MinervaBots/Trekking/mechanical/assembly/Renders/TK - 02.PNG

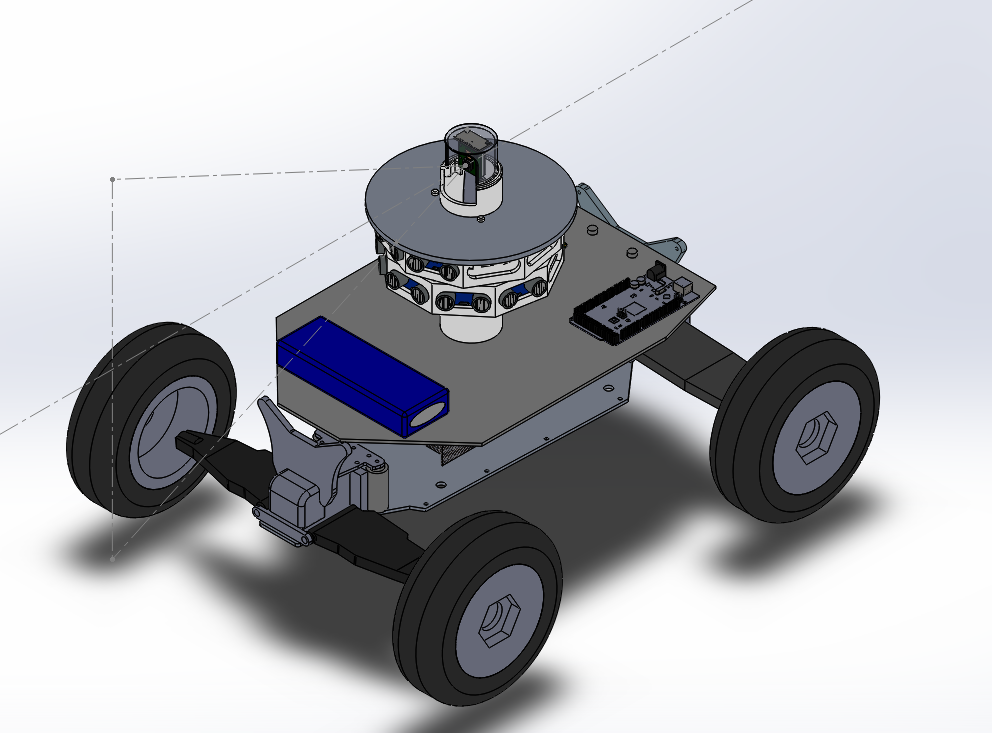
mechanical/assembly/Renders/TK - 02.PNG
