MinervaBots/Trekking/mechanical/assembly/Renders/TK - 03.PNG

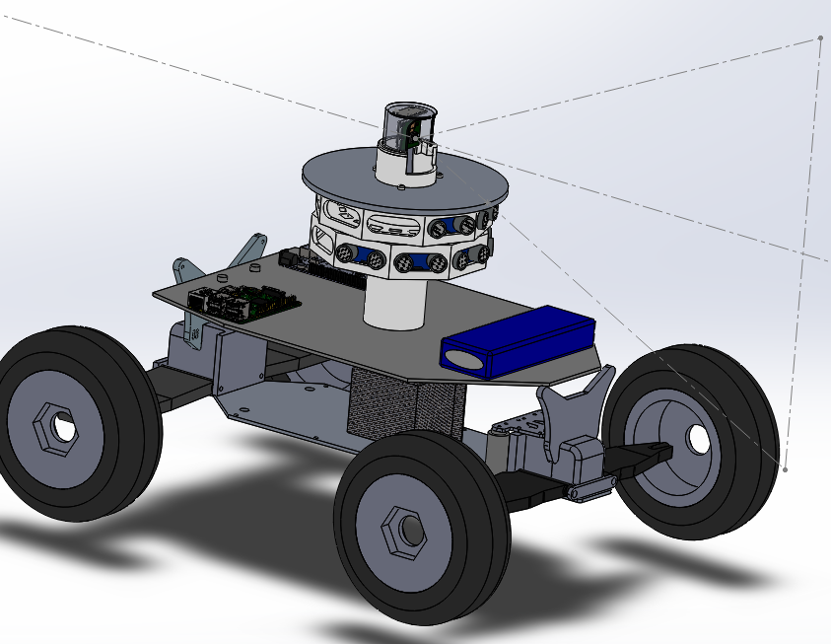
mechanical/assembly/Renders/TK - 03.PNG
