MinervaBots/Trekking/firmware/arduino/README.md

Códigos, bibliotecas e exemplos relacionados ao que rodaremos no Arduino
