MinervaBots/Trekking/mechanical/assembly/(TK) - Locomoção.SLDASM

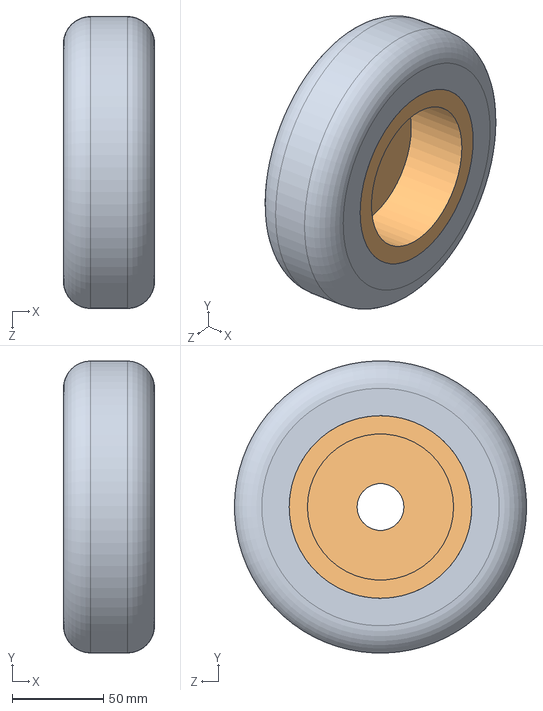
[picture p3: CAD file, 2018-03-31]
mechanical/assembly/(TK) - Locomoção.SLDASM
50.0 x 159.9 x 160.0 mm
(TK) - Pneu
(TK) - Tambor Roda
