MinervaBots/Trekking/mechanical/assembly/Componentes Shield Arduino Mega/(TK) - Shield Arduino Mega.SLDASM

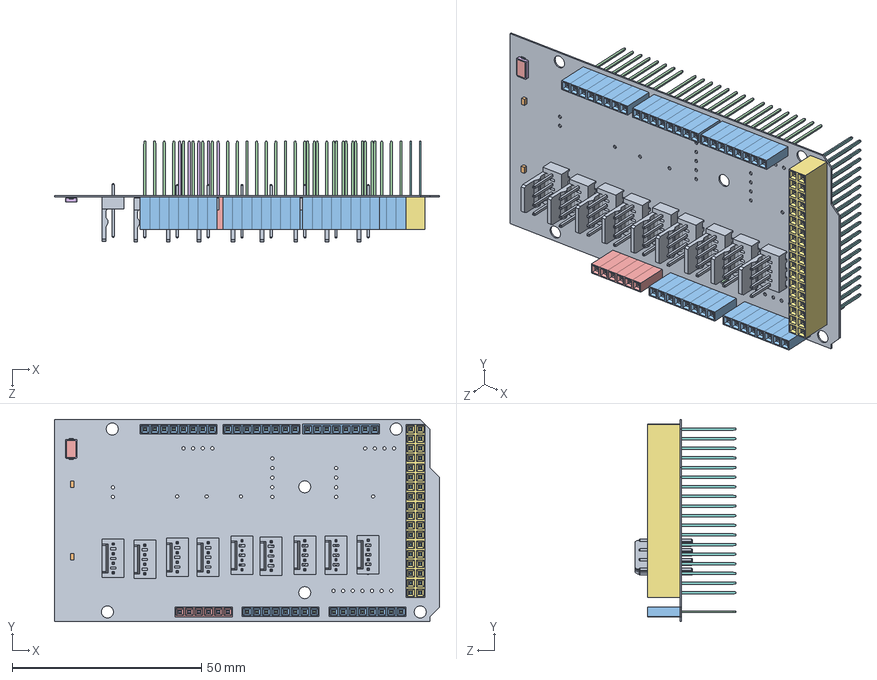
[picture p4: CAD file, 2018-03-31]
mechanical/assembly/Componentes Shield Arduino Mega/(TK) - Shield Arduino Mega.SLDASM
101.6 x 53.3 x 26.8 mm
Board
Extruded x 2
SIL_Socket_Body x 40
SIL_SocketPin x 40
SIL_Socket_Body_2 x 6
SIL_SocketPin_2 x 6
SIL_Socket_Body36
SIL_Socket_Pin36
5225_LED_SMD5630
5225_LED_SMD5630_2
5225_LED_SMD5630_3
5225_LED_SMD5630_4
5225_LED_SMD5630_5
