MinervaBots/Trekking/mechanical/assembly/(TK) - Suporte Bateria e ESC.SLDPRT

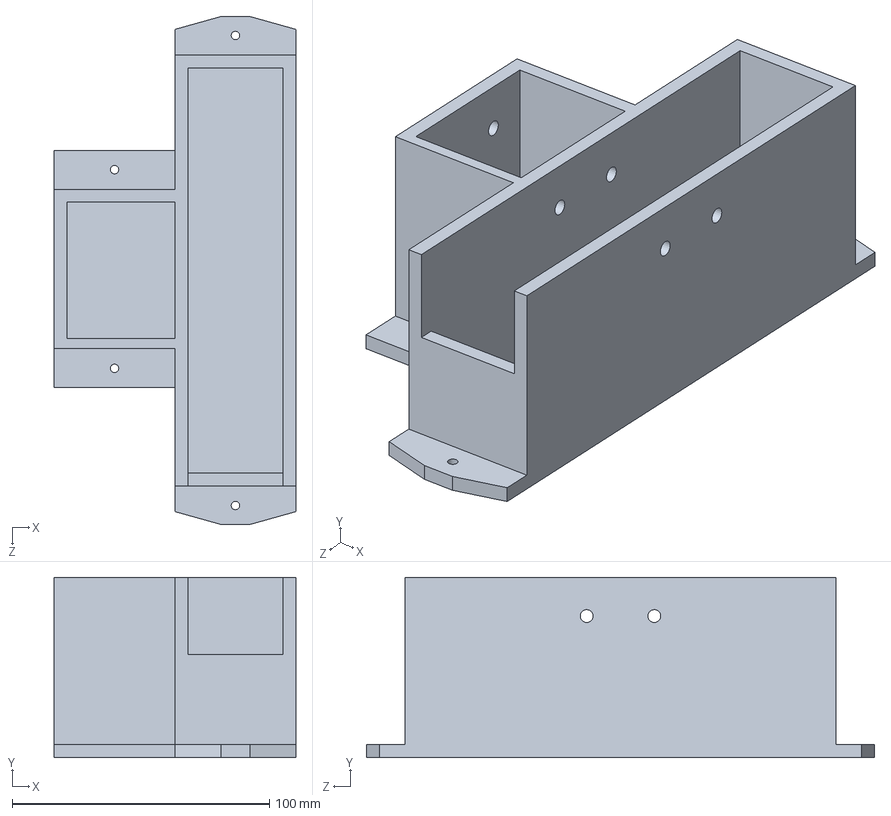
[picture p5: CAD file, 2018-04-10]
mechanical/assembly/(TK) - Suporte Bateria e ESC.SLDPRT
94.0 x 70.0 x 197.5 mm
