MinervaBots/Trekking/mechanical/assembly/(TK) - Suporte Coluna Central.SLDPRT

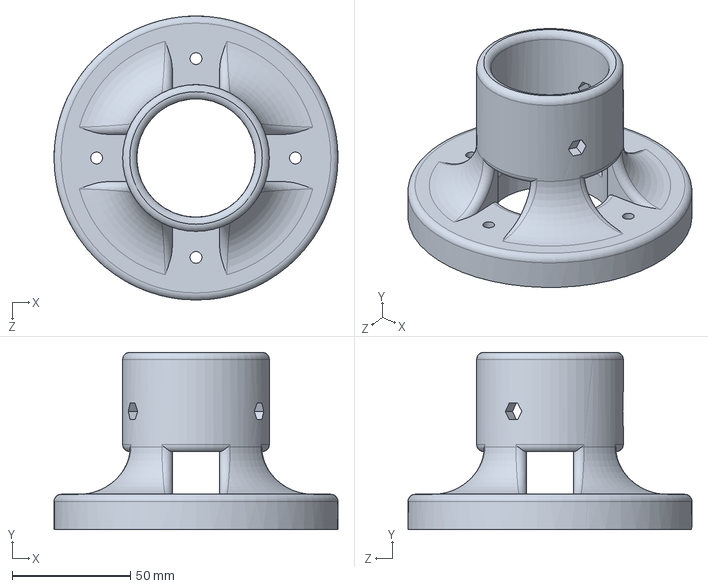
[picture p6: CAD file, 2018-04-10]
mechanical/assembly/(TK) - Suporte Coluna Central.SLDPRT
120.0 x 75.0 x 120.0 mm
