MinervaBots/Trekking/mechanical/assembly/(TK) - Suporte Servo.SLDPRT

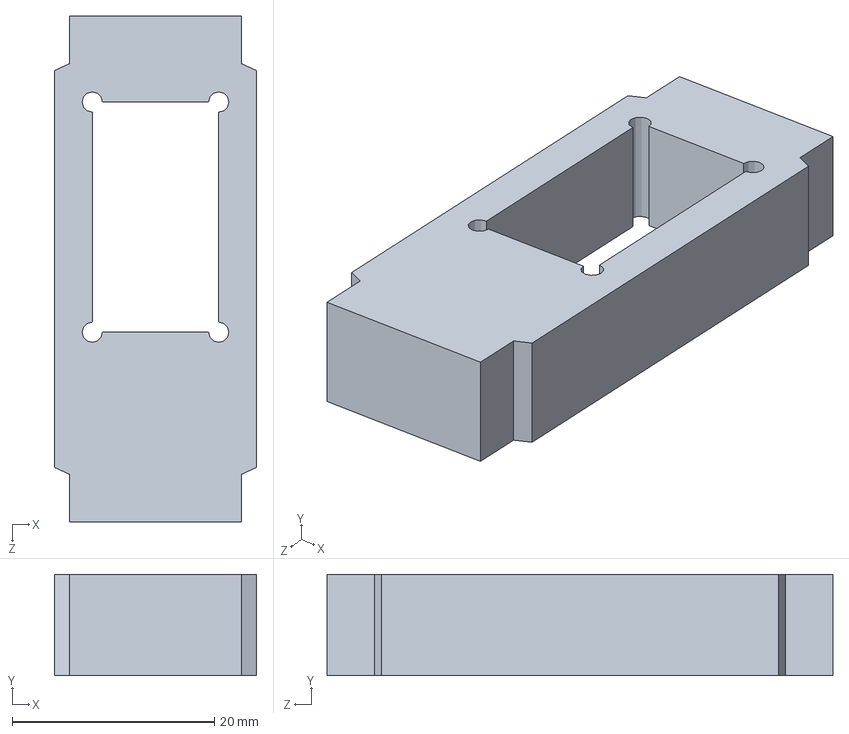
[picture p7: CAD file, 2018-04-05]
mechanical/assembly/(TK) - Suporte Servo.SLDPRT
20.0 x 10.0 x 50.0 mm
