MinervaBots/Trekking/mechanical/assembly/(TK) - Coluna Central.SLDPRT

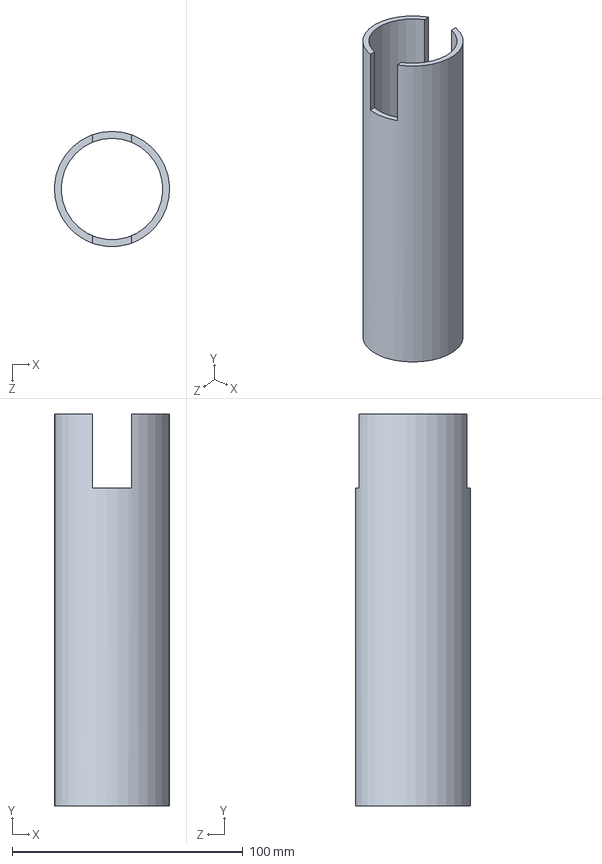
[picture p8: CAD file, 2018-04-05]
mechanical/assembly/(TK) - Coluna Central.SLDPRT
49.9 x 170.0 x 50.0 mm
