MinervaBots/Trekking/mechanical/assembly/(TK) - Braço da suspenção.SLDPRT

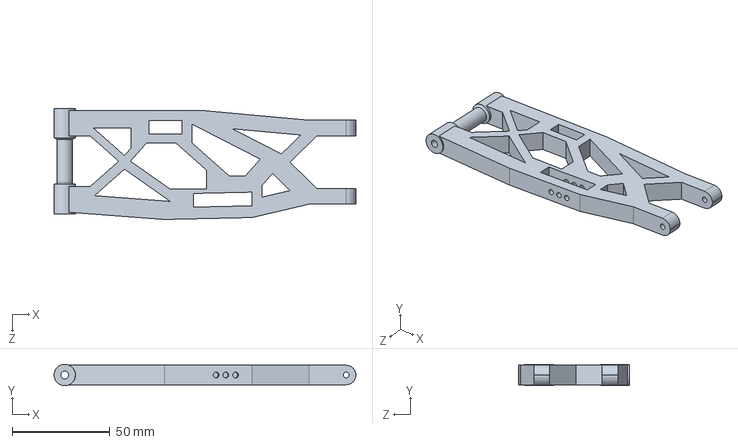
[picture p9: CAD file, 2018-04-05]
mechanical/assembly/(TK) - Braço da suspenção.SLDPRT
154.8 x 11.0 x 56.9 mm
