MinervaBots/Trekking/mechanical/assembly/(TK) - Apoio Suspensão - Frontal.SLDPRT

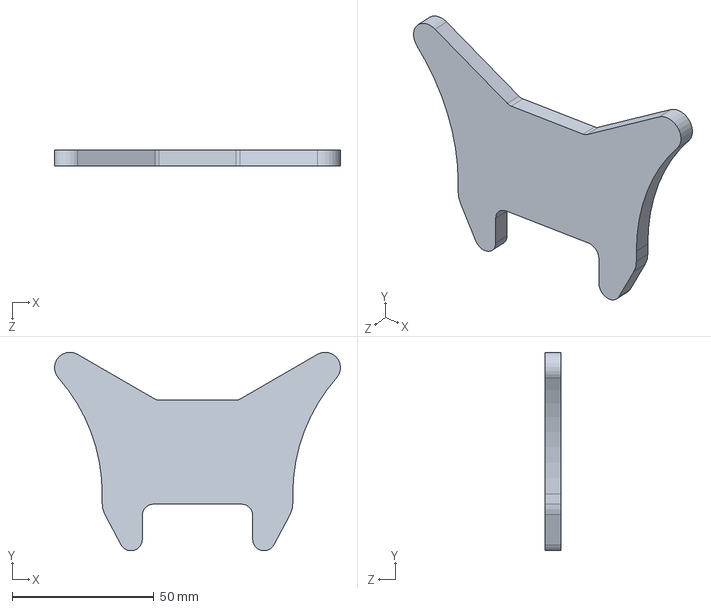
[picture p10: CAD file, 2018-04-05]
mechanical/assembly/(TK) - Apoio Suspensão - Frontal.SLDPRT
101.0 x 70.1 x 5.55 mm
