MinervaBots/Trekking/mechanical/assembly/(TK) - Base Chassi.SLDPRT

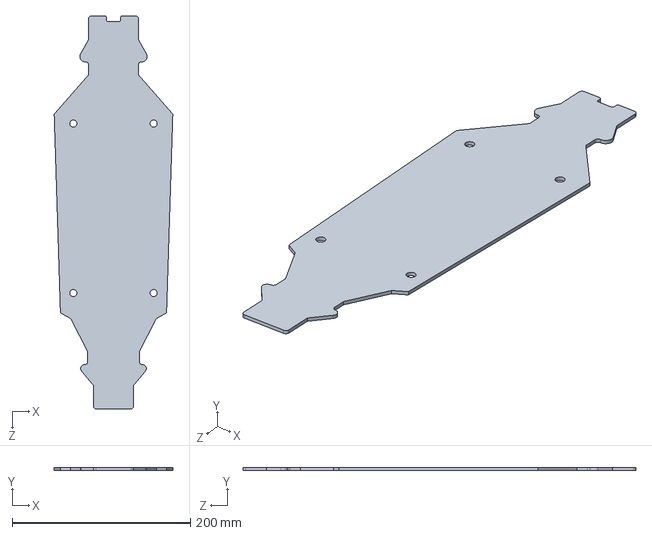
[picture p11: CAD file, 2018-03-31]
mechanical/assembly/(TK) - Base Chassi.SLDPRT
133.0 x 3.00 x 440.6 mm
