MinervaBots/Trekking/mechanical/assembly/(TK) - Arduíno Mega.SLDPRT

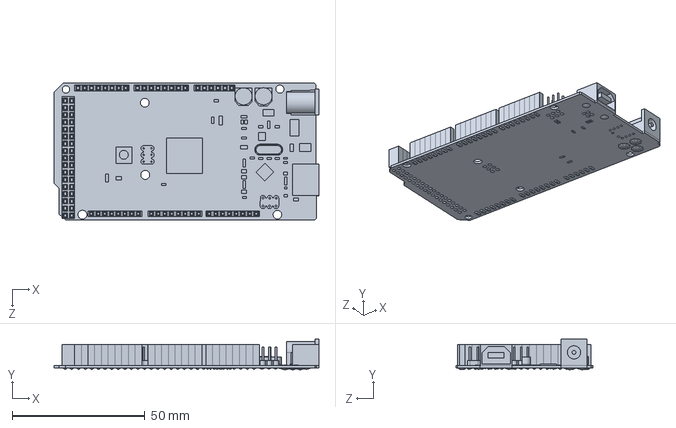
[picture p12: CAD file, 2018-03-31]
mechanical/assembly/(TK) - Arduíno Mega.SLDPRT
100.0 x 11.6 x 51.6 mm
