MinervaBots/Trekking/mechanical/assembly/(TK) - Servo Câmera.SLDPRT

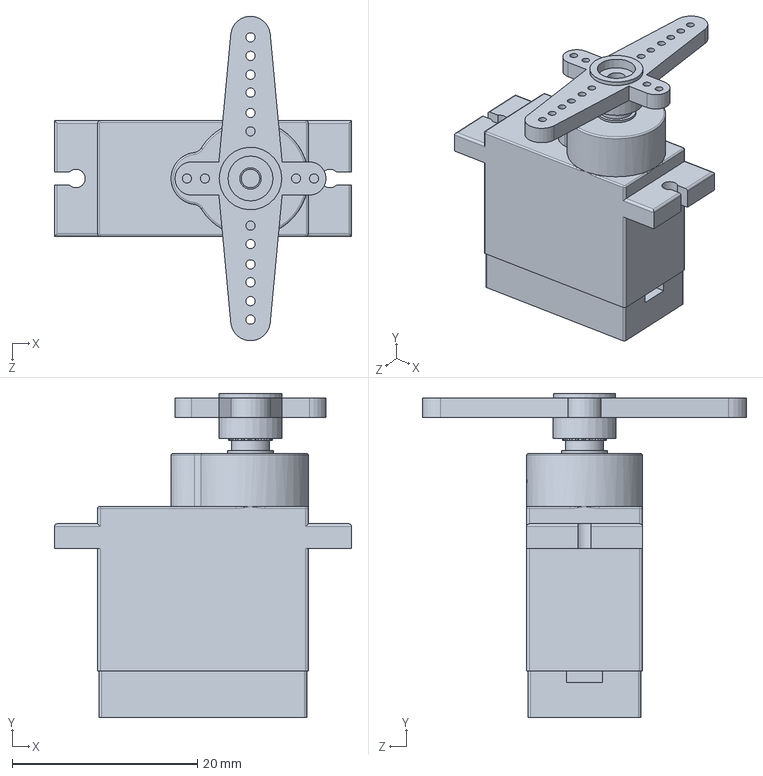
[picture p13: CAD file, 2018-03-31]
mechanical/assembly/(TK) - Servo Câmera.SLDPRT
32.0 x 35.0 x 35.0 mm
