MinervaBots/Trekking/mechanical/assembly/(TK) - Guarda Chuva Sensores.SLDPRT

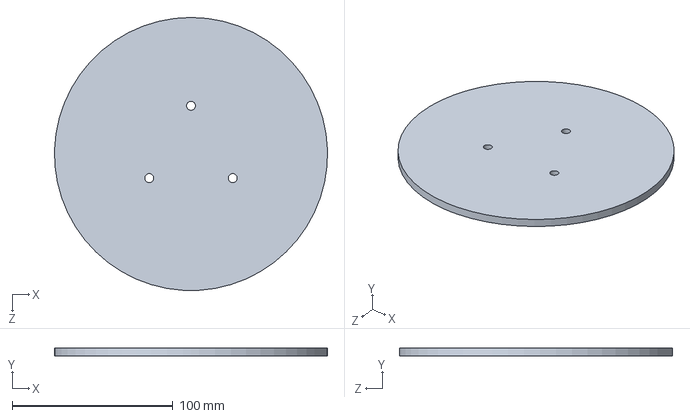
[picture p14: CAD file, 2018-03-31]
mechanical/assembly/(TK) - Guarda Chuva Sensores.SLDPRT
169.9 x 5.00 x 170.0 mm
