MinervaBots/Trekking/mechanical/assembly/(TK) - Suporte Sensores.SLDPRT

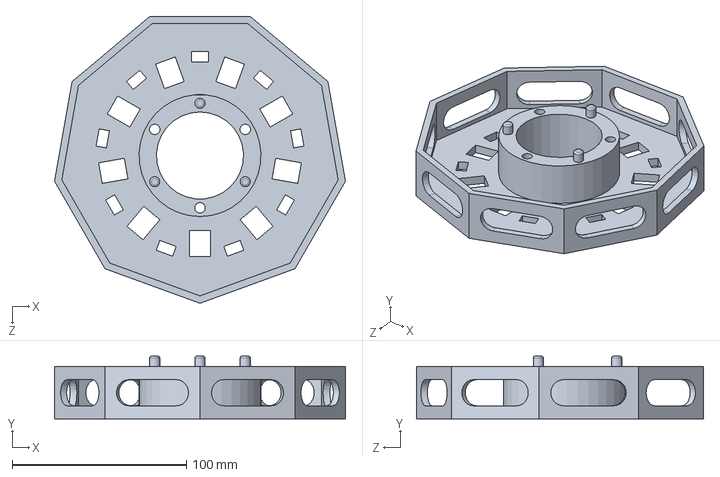
[picture p15: CAD file, 2018-03-31]
mechanical/assembly/(TK) - Suporte Sensores.SLDPRT
167.0 x 36.0 x 164.5 mm
