MinervaBots/Trekking/mechanical/assembly/(TK) - Cilindro Frontal.SLDPRT

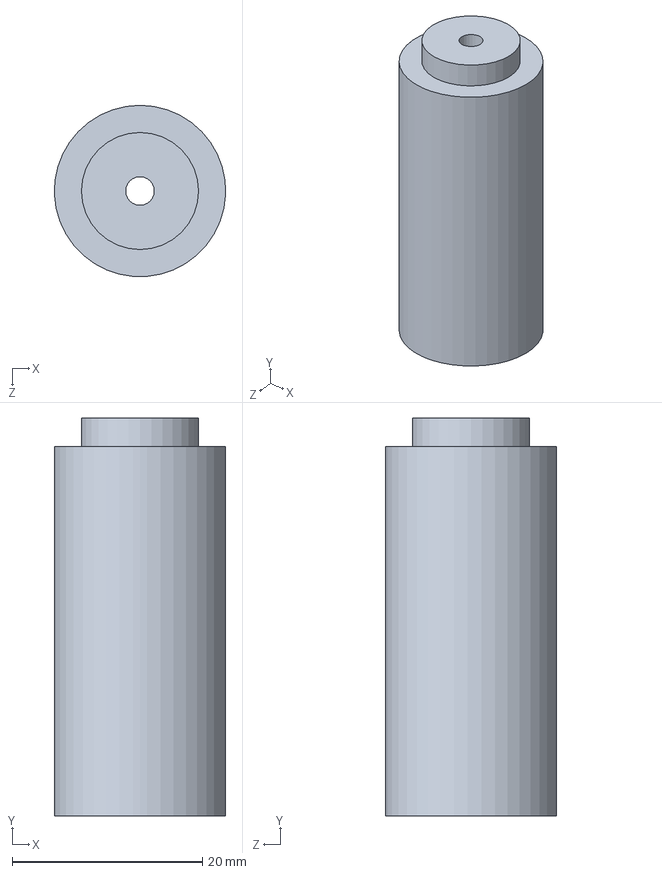
[picture p16: CAD file, 2018-03-31]
mechanical/assembly/(TK) - Cilindro Frontal.SLDPRT
18.0 x 41.8 x 18.0 mm
