MinervaBots/Trekking/mechanical/assembly/(TK) - Carcaça1.SLDPRT

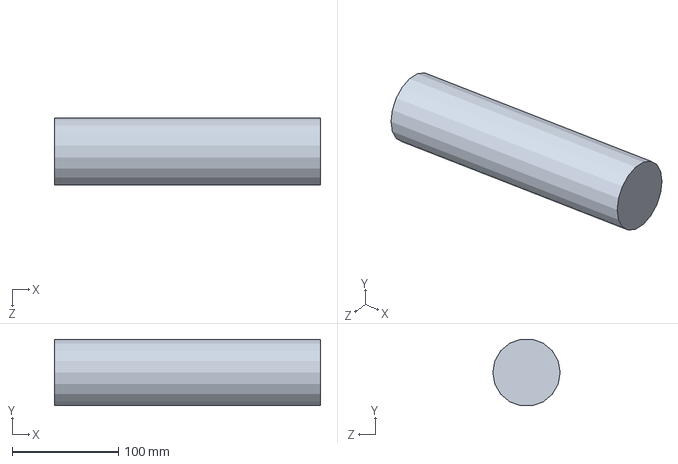
[picture p17: CAD file, 2018-03-31]
mechanical/assembly/(TK) - Carcaça1.SLDPRT
250.0 x 62.4 x 63.4 mm
