MinervaBots/Trekking/mechanical/assembly/(TK) - Tambor Roda.SLDPRT

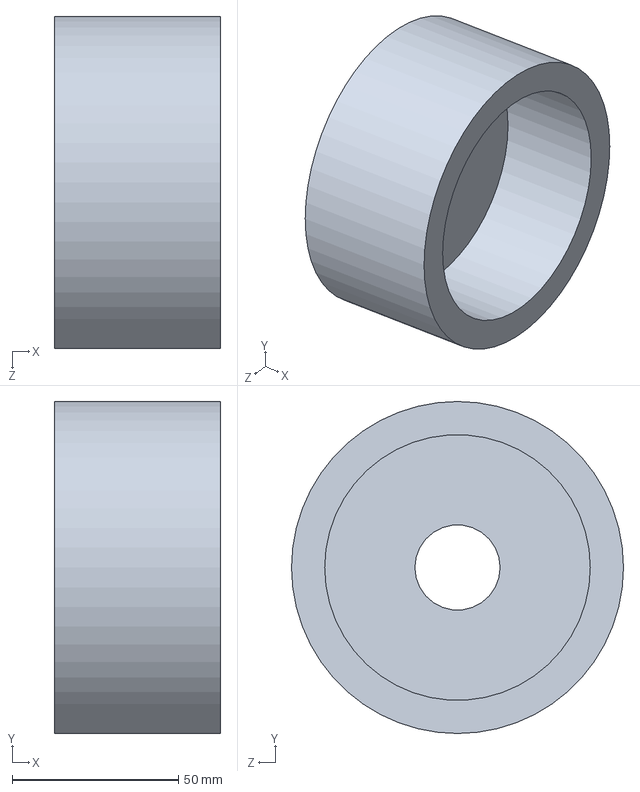
[picture p18: CAD file, 2018-03-31]
mechanical/assembly/(TK) - Tambor Roda.SLDPRT
50.0 x 100.0 x 100.0 mm
