MinervaBots/Trekking/mechanical/assembly/(TK) - Apoio Suporte Eletrônica.SLDPRT

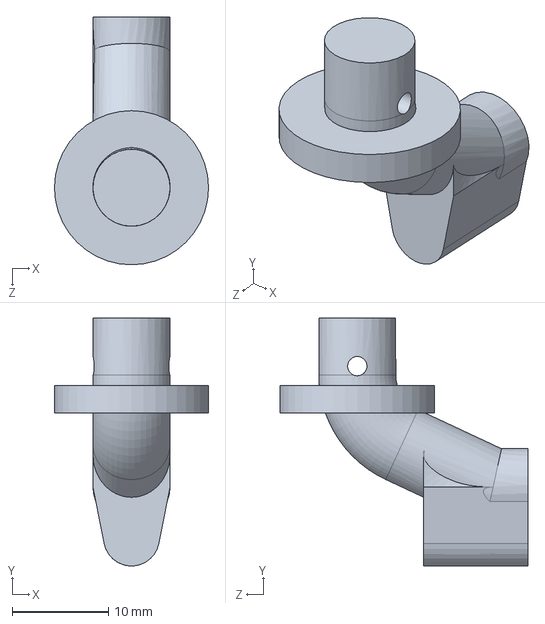
[picture p19: CAD file, 2018-03-31]
mechanical/assembly/(TK) - Apoio Suporte Eletrônica.SLDPRT
16.0 x 25.7 x 25.7 mm
