MinervaBots/Trekking/mechanical/assembly/(TK) - Apoio Diferencial - Frontal.SLDPRT

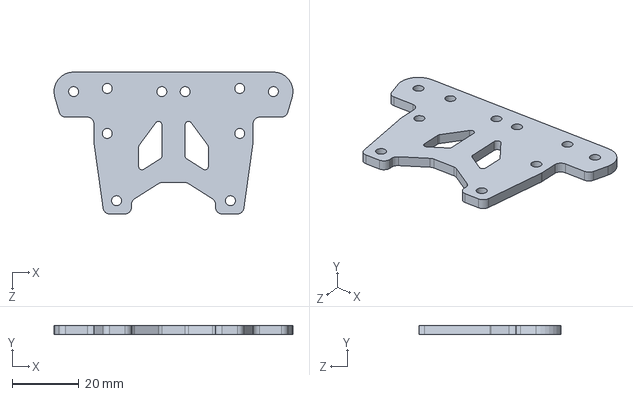
[picture p20: CAD file, 2018-03-31]
mechanical/assembly/(TK) - Apoio Diferencial - Frontal.SLDPRT
71.8 x 2.75 x 42.6 mm
