MinervaBots/Trekking/mechanical/assembly/(TK) - Suporte Eletrônica.SLDPRT

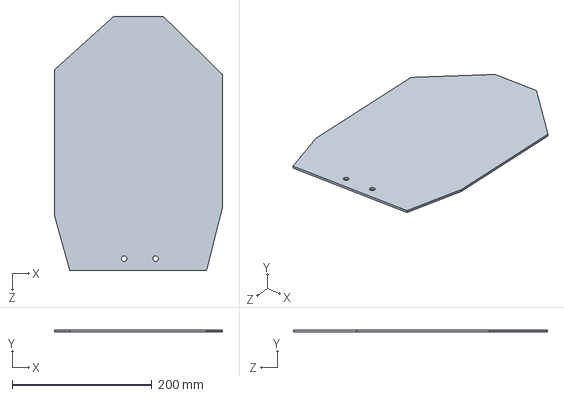
[picture p21: CAD file, 2018-03-31]
mechanical/assembly/(TK) - Suporte Eletrônica.SLDPRT
240.1 x 3.00 x 363.3 mm
