MinervaBots/Trekking/mechanical/assembly/(TK) - Parafuso Coluna.SLDPRT

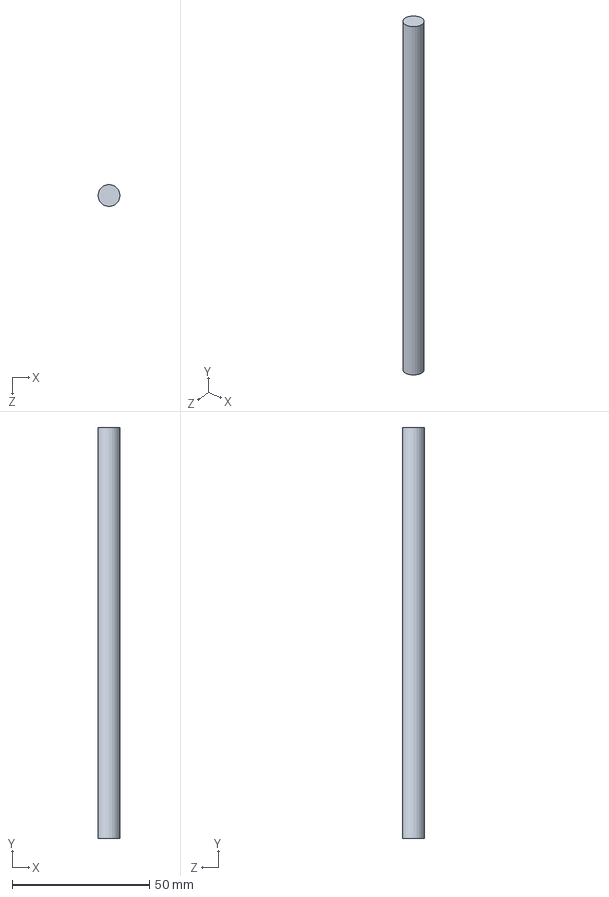
[picture p22: CAD file, 2018-03-31]
mechanical/assembly/(TK) - Parafuso Coluna.SLDPRT
8.00 x 150.0 x 8.00 mm
