MinervaBots/Trekking/mechanical/assembly/(TK) - Pneu.SLDPRT

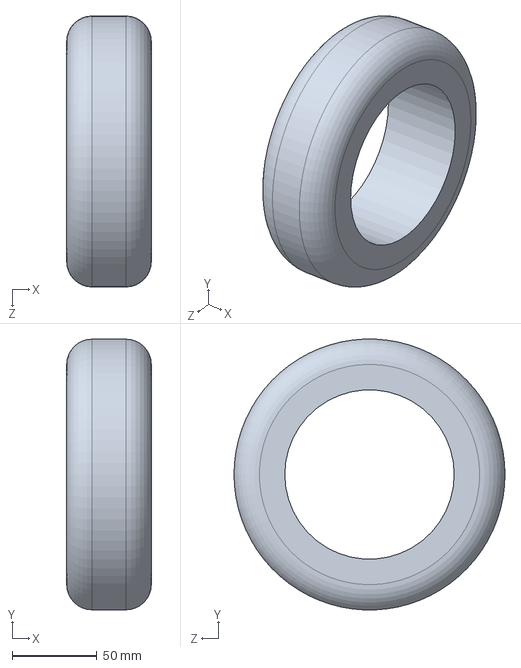
[picture p23: CAD file, 2018-03-31]
mechanical/assembly/(TK) - Pneu.SLDPRT
50.0 x 159.9 x 160.0 mm
