MinervaBots/Trekking/mechanical/assembly/(TK) - Suporte Câmera.SLDPRT

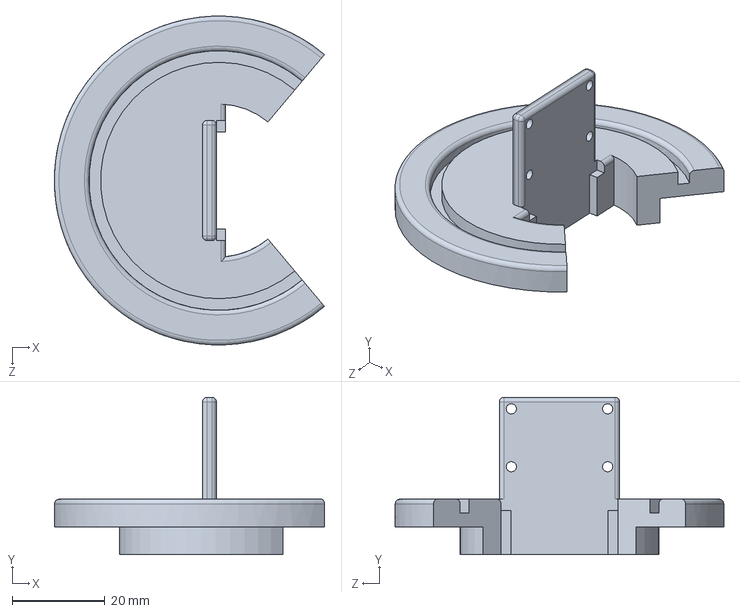
[picture p24: CAD file, 2018-03-31]
mechanical/assembly/(TK) - Suporte Câmera.SLDPRT
58.3 x 34.0 x 71.0 mm
