MinervaBots/Trekking/mechanical/assembly/(TK) - KK Macho.SLDPRT

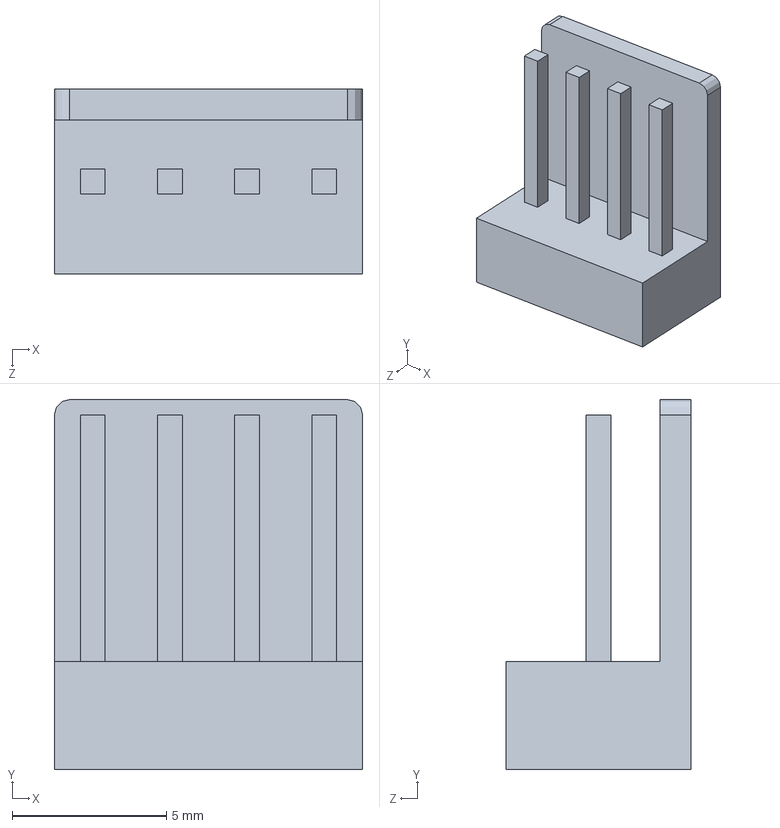
[picture p25: CAD file, 2018-03-31]
mechanical/assembly/(TK) - KK Macho.SLDPRT
10.0 x 12.0 x 6.00 mm
