MinervaBots/Trekking/mechanical/assembly/(TK) - Apoio Suspensão - Traseiro.SLDPRT

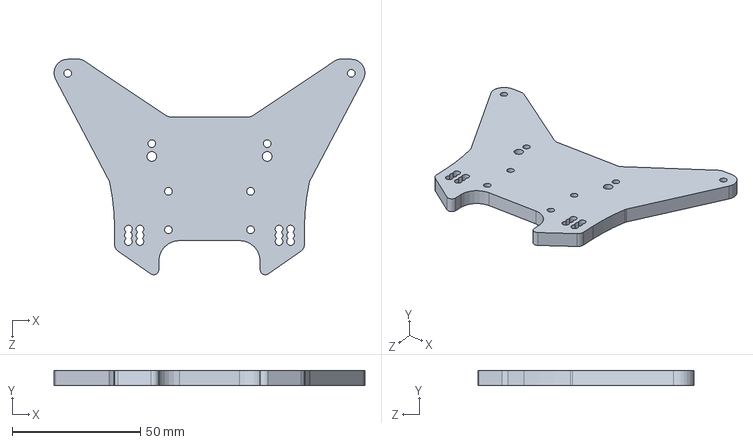
[picture p26: CAD file, 2018-03-31]
mechanical/assembly/(TK) - Apoio Suspensão - Traseiro.SLDPRT
121.2 x 5.90 x 84.0 mm
