MinervaBots/Trekking/mechanical/assembly/(TK) - Engrenagem Motor.SLDPRT

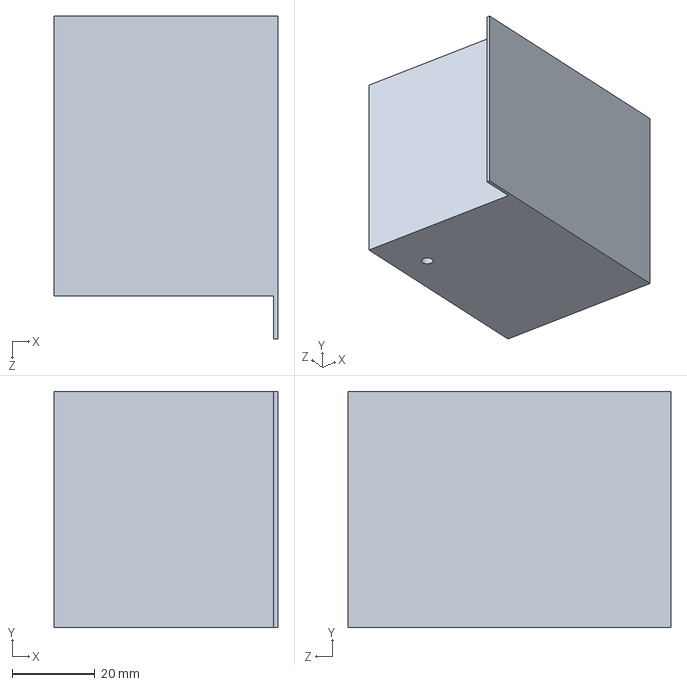
[picture p27: CAD file, 2018-03-31]
mechanical/assembly/(TK) - Engrenagem Motor.SLDPRT
54.0 x 57.0 x 78.0 mm
