MinervaBots/Trekking/mechanical/assembly/(TK) - Guarda Chuva Câmera.SLDPRT

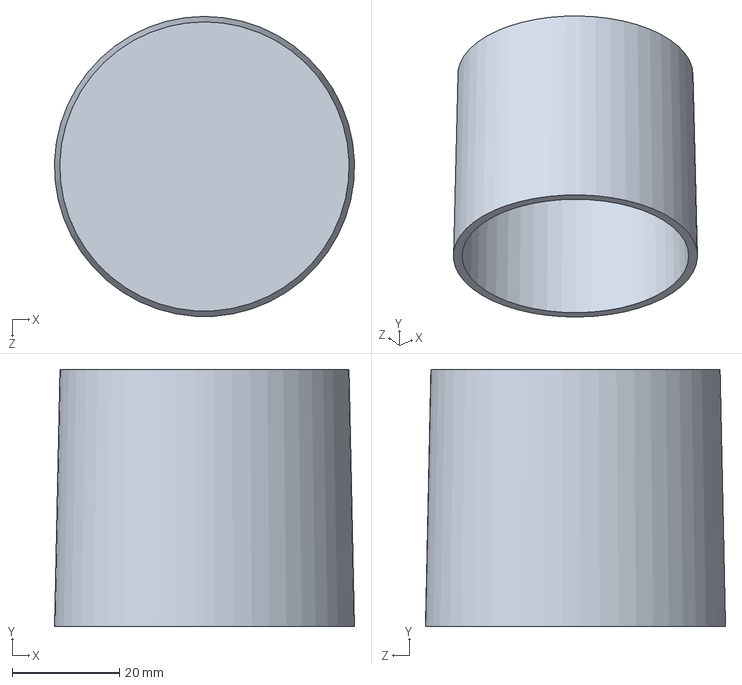
[picture p28: CAD file, 2018-03-31]
mechanical/assembly/(TK) - Guarda Chuva Câmera.SLDPRT
56.0 x 48.0 x 56.0 mm
