MinervaBots/Trekking/mechanical/assembly/(TK) - Sensor.SLDPRT

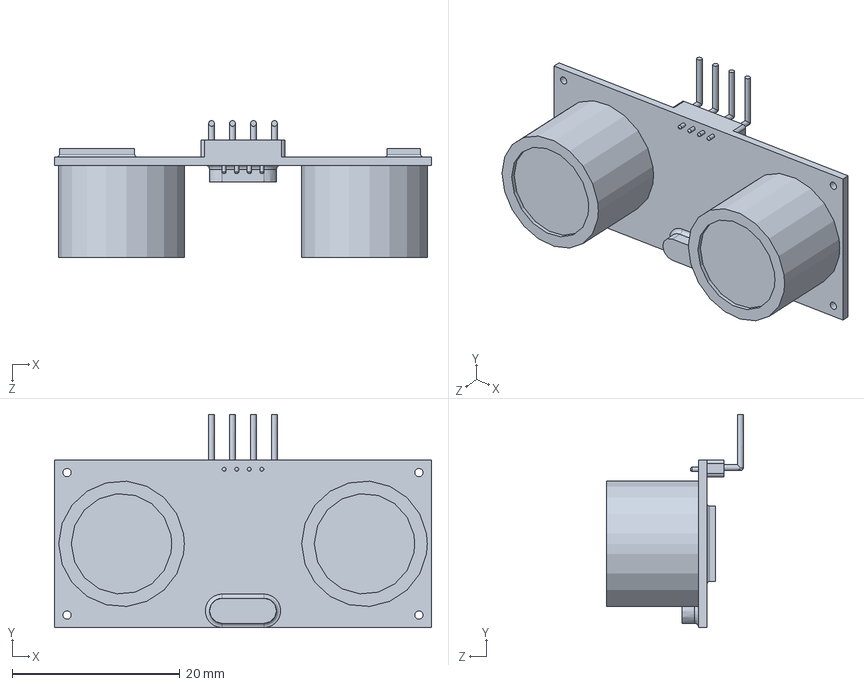
[picture p29: CAD file, 2018-03-31]
mechanical/assembly/(TK) - Sensor.SLDPRT
45.0 x 25.4 x 16.4 mm
