MinervaBots/Trekking/mechanical/assembly/(TK) - Base de Alumínio.SLDPRT

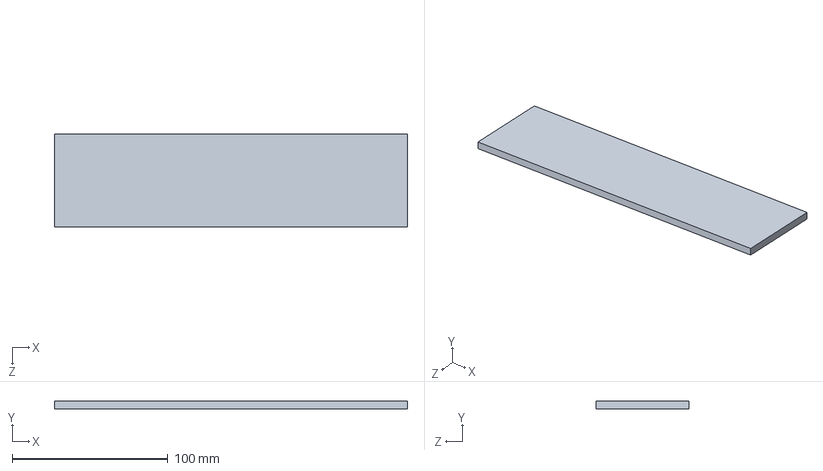
[picture p30: CAD file, 2018-03-31]
mechanical/assembly/(TK) - Base de Alumínio.SLDPRT
226.7 x 5.00 x 60.0 mm
