MinervaBots/Trekking/mechanical/assembly/(TK) - Fita de LED.SLDPRT

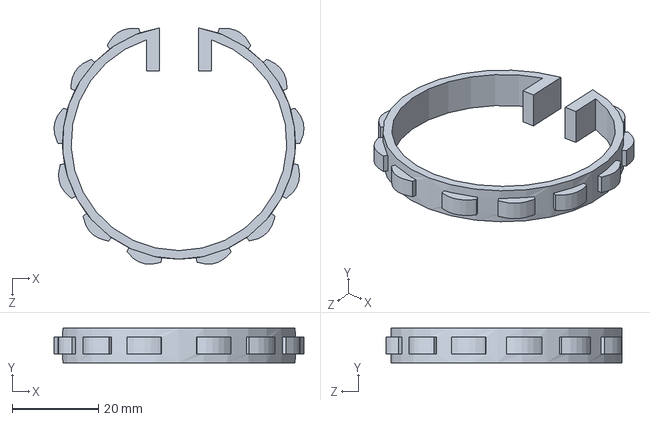
[picture p31: CAD file, 2018-03-31]
mechanical/assembly/(TK) - Fita de LED.SLDPRT
57.9 x 8.00 x 54.8 mm
