MinervaBots/Trekking/mechanical/assembly/(TK) - Engrenagens Diferencial - Frontal.SLDPRT

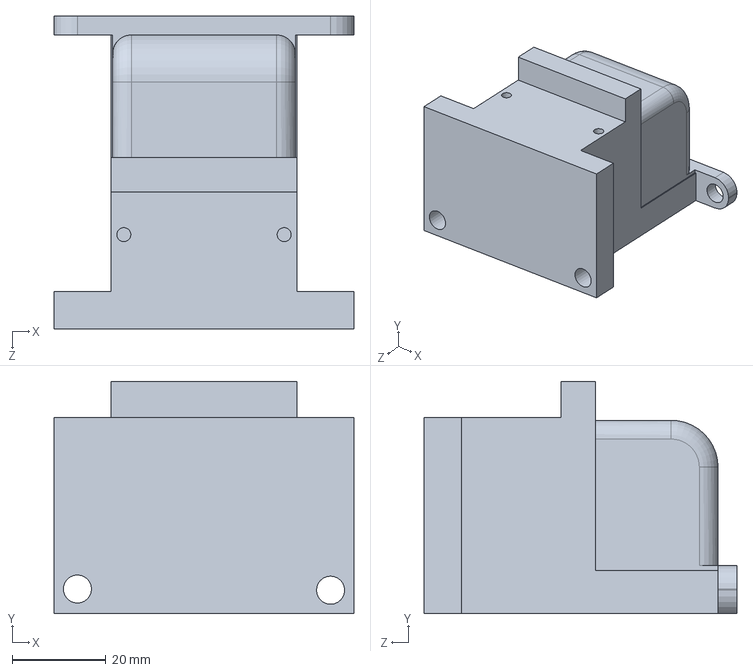
[picture p32: CAD file, 2018-03-31]
mechanical/assembly/(TK) - Engrenagens Diferencial - Frontal.SLDPRT
64.0 x 49.5 x 66.7 mm
