MinervaBots/Trekking/mechanical/assembly/(TK) - Bateria.SLDPRT

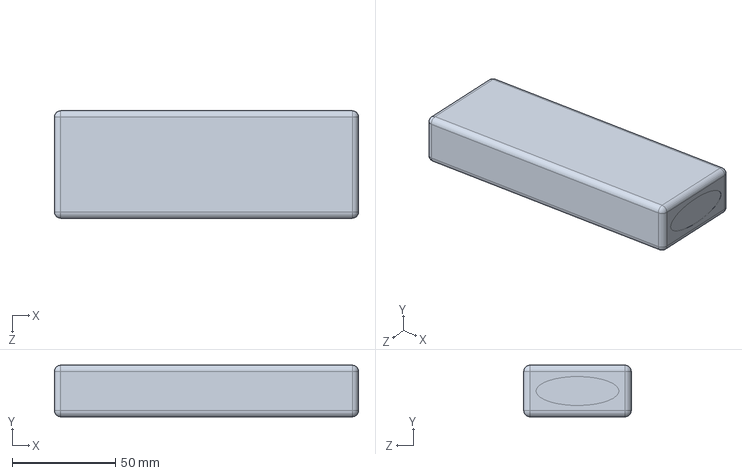
[picture p33: CAD file, 2018-03-31]
mechanical/assembly/(TK) - Bateria.SLDPRT
147.0 x 25.0 x 52.0 mm
