MinervaBots/Trekking/mechanical/assembly/(TK) - Câmera.SLDPRT

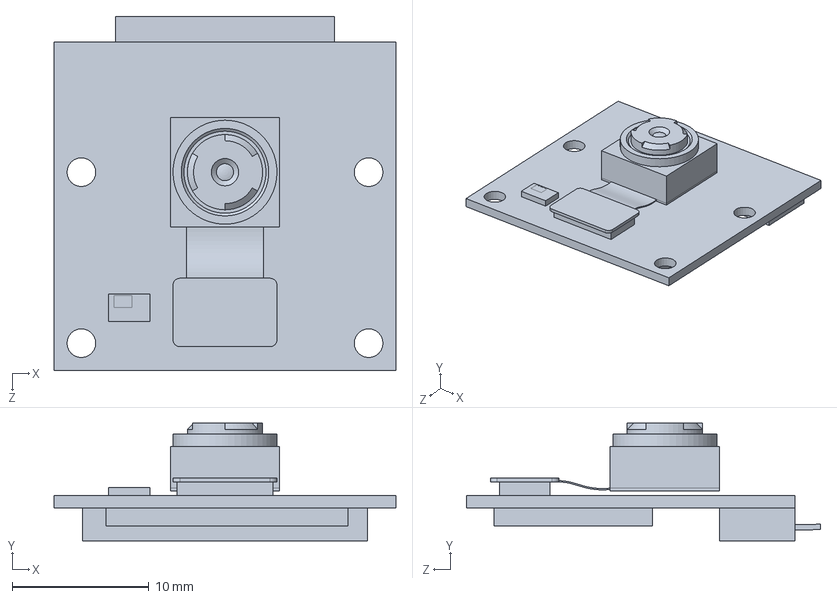
[picture p34: CAD file, 2018-03-31]
mechanical/assembly/(TK) - Câmera.SLDPRT
25.0 x 8.60 x 25.9 mm
