MinervaBots/Trekking/mechanical/assembly/(TK) - Engrenagens Diferencial - Traseira.SLDPRT

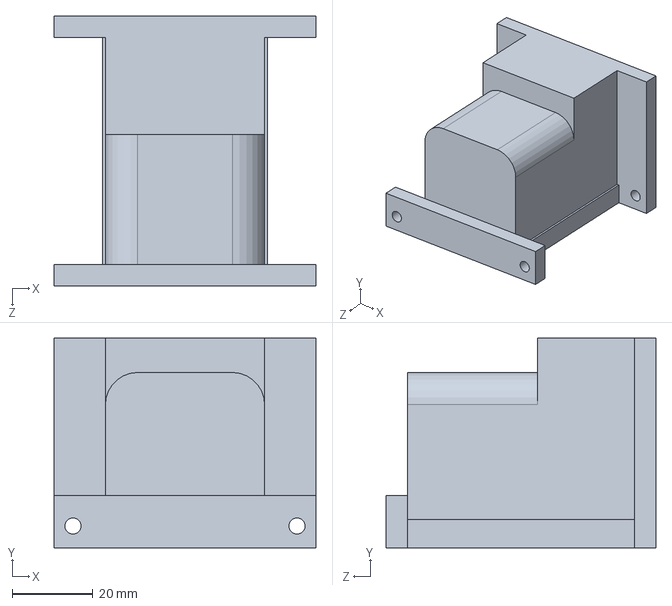
[picture p35: CAD file, 2018-03-31]
mechanical/assembly/(TK) - Engrenagens Diferencial - Traseira.SLDPRT
65.0 x 52.0 x 67.0 mm
