MinervaBots/Trekking/mechanical/assembly/(TK) - Conexão Roda - Frontal.SLDPRT

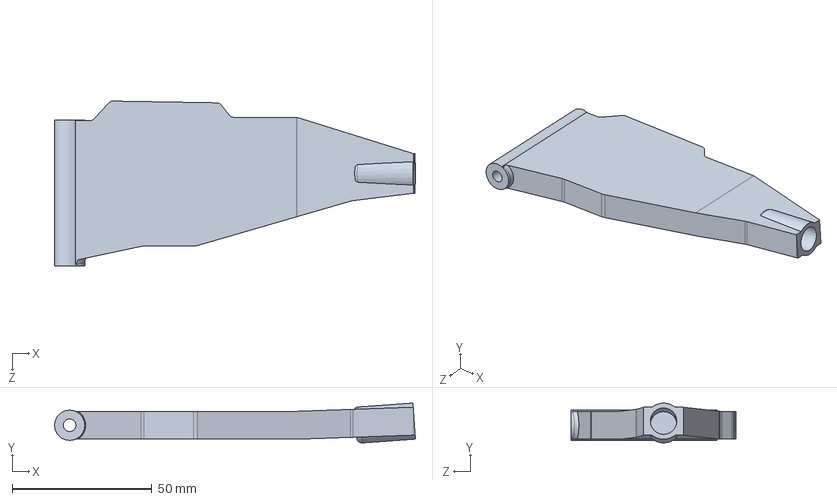
[picture p36: CAD file, 2018-03-31]
mechanical/assembly/(TK) - Conexão Roda - Frontal.SLDPRT
129.2 x 14.3 x 59.0 mm
