MinervaBots/Trekking/(list of files, cad)

Other CAD files:
mechanical/assembly/Componentes Shield Arduino Mega/POWER.sldasm
mechanical/assembly/Componentes Shield Arduino Mega/DIGITAL.sldasm
mechanical/assembly/Componentes Shield Arduino Mega/Free-Models.sldasm
mechanical/assembly/Componentes Shield Arduino Mega/R2.sldasm
mechanical/assembly/Componentes Shield Arduino Mega/COMMS.sldasm
mechanical/assembly/Componentes Shield Arduino Mega/AD_H.sldasm
mechanical/assembly/Componentes Shield Arduino Mega/AD_L.sldasm
mechanical/assembly/Componentes Shield Arduino Mega/Motores.sldasm
mechanical/assembly/Componentes Shield Arduino Mega/SIL_Socket36.sldasm
mechanical/assembly/Componentes Shield Arduino Mega/SIL_Socket08_.sldasm
mechanical/assembly/Componentes Shield Arduino Mega/SIL_Socket06.sldasm
mechanical/assembly/Componentes Shield Arduino Mega/R1.sldasm
mechanical/assembly/Componentes Shield Arduino Mega/PWM_H.sldasm
mechanical/assembly/Componentes Shield Arduino Mega/SIL_SocketPin.sldprt
mechanical/assembly/Componentes Shield Arduino Mega/5225_LED_SMD5630_5.sldprt
mechanical/assembly/Componentes Shield Arduino Mega/5225_LED_SMD5630_3.sldprt
mechanical/assembly/Componentes Shield Arduino Mega/SIL_Socket_Body36.sldprt
mechanical/assembly/Componentes Shield Arduino Mega/SIL_Socket_Pin36.sldprt
mechanical/assembly/Componentes Shield Arduino Mega/5225_LED_SMD5630_4.sldprt
mechanical/assembly/Componentes Shield Arduino Mega/5225_LED_SMD5630.sldprt
mechanical/assembly/Componentes Shield Arduino Mega/SIL_Socket_Body_2.sldprt
mechanical/assembly/Componentes Shield Arduino Mega/SIL_Socket_Body.sldprt
mechanical/assembly/Componentes Shield Arduino Mega/5225_LED_SMD5630_2.sldprt
mechanical/assembly/Componentes Shield Arduino Mega/22-27-2041.sldprt
mechanical/assembly/Componentes Shield Arduino Mega/Arduino MEGA blank shield.step
mechanical/assembly/Componentes Shield Arduino Mega/Extruded.sldprt
mechanical/assembly/Componentes Shield Arduino Mega/SIL_SocketPin_2.sldprt
mechanical/assembly/Componentes Shield Arduino Mega/Board.sldprt
mechanical/assembly/Componentes Shield Arduino Mega/1126585976.sldasm
