MinervaBots/Trekking/mechanical/assembly/Renders/TK - 01.png

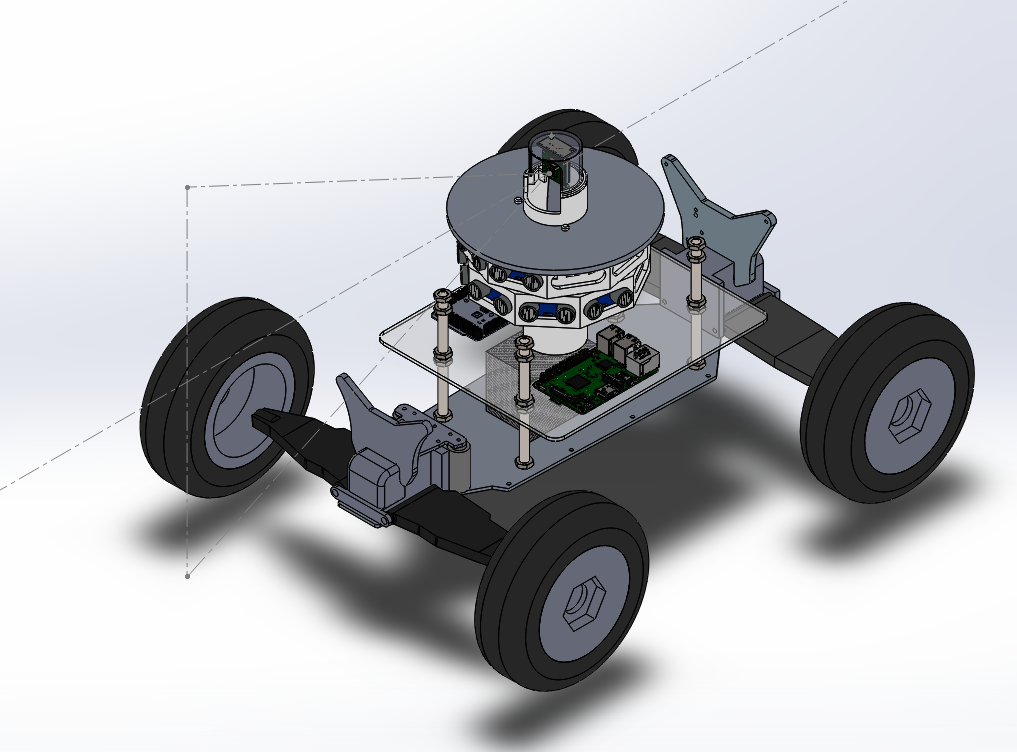
mechanical/assembly/Renders/TK - 01.png
