MinervaBots/Trekking/(list of files, drawings)

Other design files:
hardware/alimentação/Nova placa/Alimentação v2.PcbDoc
hardware/alimentação/Nova placa/Alimentação v2.SchDoc
hardware/alimentação/Placa de alimentação.PcbDoc
hardware/alimentação/Placa de alimentação.PrjPcb
hardware/alimentação/Placa de alimentação.SchDoc
hardware/alimentação/Placa teste/Placa teste.PcbDoc
hardware/alimentação/Placa teste/Placa teste.PrjPcb
hardware/alimentação/Placa teste/Placa teste.SchDoc
hardware/alimentação/placa v3/Alimentação v3.PcbDoc
hardware/alimentação/placa v3/Alimentação v3.SchDoc
hardware/shield/Arduino MEGA blank shield.pcbdoc
hardware/shield/ArduinoMegaSheild.PrjPcb
hardware/shield/Shield Arduino.SchDoc
