MinervaBots/Trekking/firmware/arduino/Mega/src/Constants.h

#ifndef CONSTANTS_H
#define CONSTANTS_H

#include "Macros.h"

#define DISTANCE_BETWEEN_AXES   0.35            // Distância entre os eixo dianteiro e traseiro (eixos das rodas) em metros

#define RPI_BAUD_RATE           9600
#define MPU_BAUD_RATE           9600

#define CAMERA_SERVO_LIMIT_MIN      30
#define CAMERA_SERVO_LIMIT_MAX      180
#define CAMERA_SERVO_ZERO                (ESC_MAX_FORWARD + ESC_MAX_BACKWARD) / 2

#define STEERING_SERVO_MIN_LIMIT    30
#define STEERING_SERVO_MAX_LIMIT    150
#define STEERING_SERVO_ZERO                (ESC_MAX_FORWARD + ESC_MAX_BACKWARD) / 2

#define ESC_MAX_FORWARD         110             // Apesar do ESC ser controlado como um servo, é mais fácil 
#define ESC_MAX_BACKWARD        80               // pensar as velocidades como valores entre [-1; 1]
#define ESC_ZERO                (ESC_MAX_FORWARD + ESC_MAX_BACKWARD) / 2

#define ULTRASSONIC_MAX_DIST    300               
#define ULTRASSONIC_TIMEOUT     CM_TO_MS(ULTRASSONIC_MAX_DIST)

#define REFINED_SEARCH_DISTANCE 7.0             // Quanto maior a distância de confiança conseguirmos com a câmera melhor
                                                // Precisa ser maior que 5 pra já estar em refinedSearch quando chegar perto dos obstáculos
#define GOAL_THRESHOLD          0.5             // Distância aceitável de um objetivo pra dizer que chagou (m)

#define BUTTON_STOP_TIME        5000
#define OBSTACLE_AVOIDANCE_CONSTANT 100.0

#define TARGET_LOST_THRESHOLD 10000

#define GEAR_MEDIUMM_VALUE 15000


#endif
