MinervaBots/Trekking/firmware/arduino/Mega/src/Pins.h

#ifndef PINS_H
#define PINS_H

#define ESC_PIN 4
#define CAMERA_SERVO_PIN 6
#define STEERING_SERVO_PIN 5

#define PIN_ULTRASSONIC_TRIGGER 48

#define LED_SIGNAL_PIN 34
#define LED_DEBUG_PIN 40

#define BUTTON_PIN 17

#define GEAR_PIN 10 // 16 -> 10
#define RUDD_PIN 2
#define ELEV_PIN 3

#define BATTERY_FEEDBACK_PIN A7
#define RPI_COOLER_PWM_PIN 9

#endif
