MinervaBots/Trekking/firmware/arduino/MPU/src/Constants.h

#ifndef CONSTANTS_H
#define CONSTANTS_H


#define PI_180 PI/180.0f
// Declinação magnética do CT (22.86047496° S, 43.2307488° W)
// No dia 04/03/2018
// http://www.ngdc.noaa.gov/geomag-web/#declination
#define MAGNETIC_DECLINATION 22.79 // 	22.79° W

#endif //CONSTANTS_H
