MinervaBots/Trekking/firmware/pi/messaging/ArduinoCommands.py

import dic
from abc import *
from typing import List
from enum import IntEnum
from .MessageHandler import *
from .MessageCodes import MessageCodes
from .BluetoothMessagingThread import BluetoothMessagingThread
from .ArduinoMessageHandlers import ArduinoMessageHandler
from .MessagingThread import MessagingThread

class ArduinoCommands(ABC):
  def __init__(self):
    self.list = []
    self.list.append([MessageCodes.TARGET_FOUND, "ff"])
    self.list.append([MessageCodes.TARGET_LOST, ""])
    self.list.append([MessageCodes.STOP_EVENT, ""])
    self.list.append([MessageCodes.TEMPERATURE, "f"])
    
