MinervaBots/Trekking/(commit log)

2017-08-27 commit inicial do código para o módulo MPU
2017-09-01 Implementação da biblioteca do sensor RGB TCS230
    Versão inicial
2017-09-04 Corrige erros de sintaxe em Tcs230.cpp
2017-09-04 Biblioteca Ultrasonic
2017-10-09 Update Ultrasonic.cpp
    Corrige o valor de retorno da função bool Ultrasonic::read(int* distance)
2017-10-09 Move a pasta do Ultrassom para a pasta das bibliotecas
2017-10-09 Biblioteca básica de locomoção
    Locomoção usando PWM e servo
2017-10-09 Padronizando a biblioteca do PID
2017-10-22 Código de detecção de objetos com OpenCV
2017-10-28 Inicio do código do Arduino Mega
    Só tem uma demonstração de como utilizar o protocolo Firmata.
2017-10-29 Melhorias no algoritmo de detecção por HaarCascade
2017-11-06 Biblioteca de distância ao cone
    Calculando a distância ou tamanho de um objeto em uma foto/imagem
    Para calcular a distância ou tamanho de um objeto em uma foto, deve-se saber os seguintes itens:
    A distância focal da lente (lens focal lenght) que a câmera utilizou na imagem;
    O tamanho do sensor (sensor size) da câmera em mm;
    O tamanho do sensor da câmera em pixels = tamanho da imagem (image size).
    E então, dois desses três itens, para computar o outro:
    O tamanho atual em pixels do objeto na imagem, largura ou altura;
    O tamanho real do objeto. A dimensão do tamanho da largura ou da altura atual ou aproximada em metros. Não necessariamente o “sujeito”, mas algum objeto conhecid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
2017-11-15 Maquina de estados finitos
2017-11-20 Move a biblioteca de locomoção para dentro do projeto
    Por ser algo bem especifico do trekking faz mais sentido ter dentro do projeto principal
2017-11-20 Correção na biblioteca de FSM
2017-11-20 Handler de mensagens arbitrarias
    Assim podemos enviar todas as informações sobre o alvo em uma unica mensagem
2017-11-20 Estados de espera e follow target
2017-12-16 Biblioteca que calcula a posição dado o vetor aceleração
    Biblioteca que recebe um vetor de aceleração e calcula a posição.
    O cálculo é feito através de duas integrais da aceleração pelo método dos trapézios.
2017-12-17 Correções no CMakeLists da biblioteca de detecção
2017-12-17 Programa de detecção com a câmera
2017-12-18 Makefile e código de detecção pela camera
2017-12-18 Código de vizualiação da câmera em Python
2017-12-18 Detecção de objeto por Haar Cascade em Python
2017-12-18 Corrige erros de identação
    [FileVideoStream.py, PiVideoStream.py]
2017-12-18 Detecção de objetos - Threaded camera
2017-12-18 Melhora a organização das pastas para usar o raspberry em modo de console
2017-12-19 Melhora o script de FPS
2017-12-19 Melhoria no script de FPS
    Agora calcula o FPS atual e o mostra o médio ao final
2017-12-20 Comunicação entre o módulo do MPU e o Arduino Mega
    E reorganização das bibliotecas
2017-12-20 Proposta de organização do código do Arduino Mega
    Remove as bibliotecas mais simples e integra elas diretamente no código. Diminui a quantidade de arquivos e melhora a legebildiade deles
2017-12-20 Organiza projeto do Raspberry Pi
    O código foi modificado pra incluir a comunicação com o Arduino, e para fins de testa agora ele rastreia rostos ao invés de cones.
2017-12-23 Comunicação com arduino em thread diferente
    A comunicação é relativamente lenta, mas não dá pra fazer muita coisa com uma porta serial.
2017-12-23 Atualiza biblioteca de PID para a verão 1.2.1
2017-12-23 Atualiza biblioteca CmdMessenger do Arduino
2017-12-23 Remove default handler e corrige erro de digitação no nome da lib
    A implementação do PyCmdMessenger não permite um handler padrão como eu queria, então estou removendo por hora até eu fazer a minha propria biblioteca de comunicação
2017-12-23 Atualiza código principal do Mega para a nova versão da biblioteca de PID
2017-12-23 Detecta se está no raspberry ou no windows
    Facilita os testes, já que em cada plataforma a câmera é usada de uma forma diferente
2017-12-23 Seleção de porta de comunicação automática
    Seleciona as portas COMX no Windows e /de/ttyACM0 no Raspberry Pi
2017-12-23 Corrige handlers não estarem sendo anexados
    [CommandHandlers.cpp, Mega.ino]
2017-12-23 Corrige import no lugar errado
    [VideoStream.py]
2017-12-23 Reativa o print de FPS
2017-12-23 Ativa janelas dependendo do OS e boot mode
    No windows sempre mostra as janelas, e no raspberry pi só mostra se estiver em desktop mode
2017-12-23 Corrige detecção de headless mode
2017-12-23 Melhora print dos dados do MPU
2017-12-23 Inicio da implementação dos estados
    Utiliza biblioteca RunningMedian para tratar o sinal enviado pelo Raspberry Pi, evitando variações muito bruscas na entrada do PID e garantindo um resulado melhor.
2017-12-23 Sistema muito burro de evitar obstáculos
    Certamente não funciona, mas preciso testar as coisas pra realmente fazer algo que funcione
2017-12-25 Erro de digitação no nome da biblioteca
2017-12-26 Corrige porta RFCOMM usada para o bluetooth no RPi
2017-12-26 Corrige ordem de operações ao finalizar as threads
2017-12-26 Checagem de presença de cor ao detectar objeto
    Ajuda a termos certeza de que realmente é um cone, jé que o método de haar cascade não considera informações de cor
2017-12-26 Inicializa a camera somente quando requisitado
    E também só roda o código de detectção quando requisitado.
    Evita gastar processamento tentando reconhecer o cone de muito longe, e economiza bateria
2017-12-26 Abre a stream do bluetooth ao iniciar a thread
2017-12-26 Diminui o settle_time do entre o RPi e o Arduino
2017-12-26 Evasão de obstáculos levemente melhorada
2017-12-26 Corrige variável usada na evação de obstáculos
    [States.cpp]
2017-12-26 Corrige o nome do paametro dos estados e verifica o caso de ficar preso num obstáculo
    [States.cpp, States.h]
2017-12-26 Remove recvTime dos comandos enviados pelo arduino
2017-12-26 Inicializa e pausa a detecção na transição de estado
    Quando mudar pro refinedSearch começa a tentar detectar com a câmera, e quando sair de refinedSearch pausa a detectção
2017-12-26 Muda algumas declarações de lugar pra facilitar o acesso
2017-12-26 Executa o PID depois da função de estado
    Permite que os valores sejão alterados e depois calculados pelo PID. Assim não devemos ter mudanças muito bruscas na nos valores entre loops
2017-12-26 Simplifica a lógica de ré ao chegar no objetivo
2017-12-26 Usa uma constante pra limitar a velocidade máxima
2018-01-13 Organiza o projeto em arduino para utilizar o VSCode como IDE
    A IDE do Arduino é extremamente limitada. Não possui auto complete, highlight de sintaxe muito limitado, não permite incluir bibliotecas especificas do projeto diretamente nele. Então estou fazendo a mudança pro VS Code + PlatformIO pra podermos ter tudo isso.
    * Remove exemplos das bibliotecas;
    * Corrige um erro no calculo da posição usando dados do MPU
    [CommandHandlers.cpp, CommandHandlers.h, Constants.h, Macros.h, Mega.ino, Pins.h, States.cpp, States.h]
2018-01-14 Adiciona arquivo para testar um cascade
2018-01-14 Função de avaliar os sensores
2018-01-14 Remove calculos no meio de código e substitui por macros
2018-01-18 Melhora wrapper de detecção
    Remove os parâmetros relacionados a desenhar os retangulos detectados na tela
2018-01-18 Wrapper para os metodos de detecção implementados no OpenCV
    Os algoritmos de tracking tem algumas vantagens quanto a detectção continua por cascade. Sendo eles:
    -Detecção mais estável, principalmente em movimento;
    -Alguns tem uma tolerancia a obstrução do objeto sem perder a posição dele;
    -Dependendo do algortimo pode ser muito mais rápido (no meu windows o MEDIANFLOW foi 3x mais rápido);
    Mas tem um contra:
    -A área detectado pode não responder muito bem a aproximação do objeto. Continua sendo detectado mas a área de detecção é igual então não podemos calcular a distância com confiança.
    Minha ideia pra evitar isso é a cada 1 segundo rodar a detecção por cascade d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
2018-01-18 Melhora o sistema de debug
    Se estiver em modo janela, permite escrever o texto no frame, mas se estiver em console, printa o texto no console
2018-01-19 Melhora a implementação da classe do wrapper Tracker
    Agora o código de detecção roda junto com o de tracking. De 1s em 1s refaz a detecção pra garantir que o bounding box do tracker está proximo da realidade
2018-01-19 Torna mais claro o código de mapeamento da posição em direção
2018-01-20 Padroniza separadores de campos e comandos na comunicação por bluetooth
    Os separadores agora são iguais a comunicação com o Arduino. Futuramente vai ser tudo parte de uma mesma biblioteca, mas por hora está bom
2018-01-20 Habilita a configuração de resolução e framerate de webcams
2018-01-20 Permite definir por bluetooth o metodo de tracking
    Se nenhum metodo for definido utiliza somente a cascade. Caso algum metodo inválido seja enviado por bluetooth fica com o ultimo válido selecionado
2018-01-21 Permite obter entrada do teclado através da janela de debug
2018-01-21 Melhora a utilização do Tracker em modo de Cascade
    E remove uma conversão desnecessária da bounding box do objeto de uma lista para uma tupla de inteiros
2018-01-21 Recebe a entrada do teclado e finaliza o programa se ESC for pressionado
2018-01-21 Otimiza janela de debug no RPi
    No Raspberry Pi vamos rodar o código no console (sem janela) então não faz sentido esperar 1ms pelos inputs de teclado ou atualizar coisas relacionadas a GUI, já que não temos GUI
2018-01-21 Melhora medida de FPS
2018-01-21 Reordena inicialização das classes para que a câmera seka inicializada primeiro
    Enquanto o código espera o comando de iniciar por bluetooth a câmera do raspberry pi tem tempo de esquentar e começar a funcionar
2018-01-21 Implementa monitor de temperatura
    A ideia é que no futuro usarmos esse codigo pra controlar um cooler através de um mosfet
2018-01-21 Atualiza gitignore para não incluir configurações do Visual Studio Code
2018-01-26 Limita o tamanho da fila de saida
2018-02-13 Projeto reorganizado para utilizar injeção de dependencia
    Assim fica mais simples manter o acesso as instancias e organizar os handlers das mensagens enviadas por bluetooth e pelo arduino
2018-02-14 Corrige lógica de separação de mensagens
    E altera o nome do arquivo pra fazer mais sentido
    [MessagingThread.py]
2018-02-14 Corrige nome do arquivo alterado no ultimo commit
    E inclui handler para solicitar FPS e temperatura da CPU
    [ArduinoMessageHandlers.py, ArduinoMessagingThread.py, BluetoothMessageHandlers.py, BluetoothMessagingThread.py, CommonMessageHandlers.py]
2018-02-15 Implementa de gravação do vídeo no programa
    Corrige erros com a resolução do video
    [PiVideoStream.py, VideoStream.py, WebcamVideoStream.py]
2018-03-17 Inclui bibliotecas do código do Arduino Mega
2018-03-17 Primeiro commit do projeto de monitor
2018-03-17 Muda codec de gravação do código em python
2018-03-17 Inicio da leitura dos ultrassons por largura de pulso
2018-03-21 Modifica a UI para funcionar por botões e não menus
2018-03-26 Reorganiza repositório para conter arquivos de eletrônica
2018-03-26 Shield atualizado
    [Arduino MEGA blank shield.pcbdoc, ArduinoMegaSheild.PrjPcb, Header.PcbLib, Header.SchLib, KK Conectors.SchLib, KK Connectors.PcbLib, KK2.STEP, KK4.STEP]
2018-03-28 Alterações dos pinos analógicos
    Os pinos anteriormente utilizados não suportavam interrupção
    [Arduino MEGA blank shield.pcbdoc, ArduinoMegaSheild.PrjPcb, Shield Arduino.SchDoc]
2018-03-28 Remove nomes no fundo da placa
    Remove as faltosas da capacitação
    [Arduino MEGA blank shield.pcbdoc]
2018-03-28 Recoloca os nomes do fundo da placa
    [Arduino MEGA blank shield.pcbdoc]
2018-03-29 Atualização da programação dos sensores de ultrassom por interrupção
2018-03-30 .gitignore para os arquivos do altium
2018-03-30 Corrige .gitignore para o PlatformIO
2018-03-30 Remove arquivos que não deveriam ir para o git
2018-03-30 Remove biblioteca do sensor de cor
2018-03-30 Remove arquivos de preview do Altium
2018-03-30 Criação do projeto e do esquematico
    [Placa de alimentação.PrjPcb, Placa de alimentação.SchDoc]
2018-03-30 Envia atualização 9 da montagem do drive
    [(TK) - Apoio Diferencial - Frontal.SLDPRT, (TK) - Apoio Suporte Eletrônica.SLDPRT, (TK) - Apoio Suspensão - Frontal.SLDPRT, (TK) - Apoio Suspensão - Traseiro.SLDPRT, (TK) - Arduíno Mega.SLDPRT, (TK) - Base Chassi.SLDPRT, (TK) - Base de Alumínio.SLDPRT, (TK) - Bateria.SLDPRT]
2018-03-31 Esquematico com modelo inicial dos circuitos
    O circuto base do regulador 7805 e da alimentação do led
    [Placa de alimentação.PrjPcb, Placa de alimentação.SchDoc]
2018-04-01 Controle do led
    [Placa de alimentação.SchDoc]
2018-04-01 Cria projeto do VSCode para o código do MPU
2018-04-01 Código de exemplo da SparkFun com um fusão dos 3 sensores
2018-04-02 Correção de componentes
    [Placa de alimentação.PcbDoc, Placa de alimentação.SchDoc]
2018-04-02 Arrumação do esquemático e adição de bibliotecas
    Arrumação dos valores dos capacitores, adição do XT90 nas bibliotecas e troca de alguns conectores para KK.
    [Placa de alimentação.PcbDoc, Placa de alimentação.SchDoc]
2018-04-02 Pequenos ajustes
    [Placa de alimentação.PrjPcb, Placa de alimentação.SchDoc]
2018-04-03 Corrige referência para as bibliotecas do projeto
    Agora todas as bibliotecas estarão na pasta "hardware/libraries".
    [Arduino MEGA blank shield.pcbdoc, ArduinoMegaSheild.PrjPcb, Placa de alimentação.PcbDoc, Placa de alimentação.PrjPcb, Shield Arduino.SchDoc]
2018-04-03 Deleta bibliotecas redundantes
    [Header.PcbLib, Header.SchLib, KK Conectors.SchLib, KK Connectors.PcbLib]
2018-04-03 Organiza bibliotecas do Altium
    [Arduino MEGA blank shield.pcbdoc, ArduinoMegaSheild.PrjPcb, Placa de alimentação.PcbDoc, Placa de alimentação.PrjPcb, Placa de alimentação.SchDoc, Shield Arduino.SchDoc]
2018-04-03 Teste para ver se eu consigo salvar algo no git
    [Placa de alimentação.PcbDoc]
2018-04-03 Organização inicial do pcb
    [Placa de alimentação.PcbDoc]
2018-04-03 Organiza diretório dos steps
    [Arduino MEGA blank shield.pcbdoc, ArduinoMegaSheild.PrjPcb, Placa de alimentação.PcbDoc]
2018-04-03 Inicio da biblioteca de componentes gerais
2018-04-04 Começo da reorganização da placa
    Separei os componentes que nao tem um lugar mais especifico em "sequencias" dos circuitos, deixando os componentes com lugares mais especificos perto dos mesmos e adicionei o LED de teste na saida do 5V e
    [Placa de alimentação.PcbDoc, Placa de alimentação.PrjPcb, Placa de alimentação.SchDoc]
2018-04-04 Começo da nova organização
    Adaptação das posições para otimização das conexões
    [Placa de alimentação.PcbDoc]
2018-04-04 Conserto dos valores dos capacitores
    [Placa de alimentação.SchDoc]
2018-04-04 Componentes para a placa de alimentação
    Fiz os footprints de alguns componentes que tem na placa.
    -Mosfet,
    -78xx,
    -LED.
    Falta o dos capacitores
    [Placa de alimentação.PcbDoc, Placa de alimentação.PrjPcb, Placa de alimentação.SchDoc]
2018-04-04 Outros componentes na biblioteca da placa de alimentação
    [Placa de alimentação.PcbDoc, Placa de alimentação.PrjPcb, Placa de alimentação.SchDoc]
2018-04-05 Tentativa de ajeitar os componetes
    [Placa de alimentação.PcbDoc, Placa de alimentação.SchDoc]
2018-04-05 Tentativa de arrumação das trilhas
    [Placa de alimentação.PcbDoc]
2018-04-05 Conectores para jumper e Malha
    [Placa de alimentação.PcbDoc, Placa de alimentação.SchDoc]
2018-04-05 Refaz o roteamento da placa de alimentação
    [Placa de alimentação.PcbDoc, Placa de alimentação.SchDoc]
2018-04-05 Muda tipo de mosfet de N para P
    E outras besteiras
    [Placa de alimentação.PcbDoc, Placa de alimentação.SchDoc]
2018-04-05 Sistema de comandos no código do MPU
2018-04-05 Inicio do novo sistema de desvio de obstaculos
2018-04-05 Inverte pinos do MOSFET
    [Placa de alimentação.PcbDoc, Placa de alimentação.SchDoc]
2018-04-05 Substitui conexão de roda traseira por uma mais fiel
    Peça ainda não tem material nem cor definida.
    Ainda não está no tamanho correto.
    [(TK) - Braço da suspenção.SLDPRT, (TK) - Conexão Roda - Traseira.SLDPRT]
2018-04-05 Define material e cor da peça "braço de suspenção"
    Mudar o nome para "braço de suspenção traseiro"
    [(TK) - Apoio Suspensão - Frontal.SLDPRT, (TK) - Braço da suspenção.SLDPRT]
2018-04-05 Adiciona suporte da bateria/esc na montagem
    [(TK) - Suporte Bateria e ESC.SLDPRT]
2018-04-05 Atualiza peças na montagem
    [(TK) - Coluna Central.SLDPRT, (TK) - Suporte Coluna Central.SLDPRT, (TK) - Suporte Servo.SLDPRT]
2018-04-06 Versão 1 da placa de alimentação
    [Placa de alimentação.PcbDoc, Placa de alimentação.PrjPcb]
2018-04-09 Código de sinalização ao chegar no alvo
2018-04-09 Código de tratamento do botão
2018-04-09 Desabilita calculo do PID enquanto pausado
    E corrige lógica do botão
    [Mega.ino, States.cpp, States.h, Variables.h]
2018-04-09 Nova tentativa de evasão de obstáculos
2018-04-09 Nova estratégia de evasão de obstácuos
    Mais simples e acho que funciona melhor
2018-04-09 Torna o sistema capaz de não sinalizar ao chegar num alvo
    Isso pode ajudar a evitar os obstáculos
2018-04-09 Padroniza sistema de mensagens entre os dispositivos
2018-04-09 Diminui a velocidade máxima do robô caso o cone não esteja sendo detectado
    É necessário conseguir uma forma melhor de implementar essa rampa de desaceleração.
2018-04-09 Computa o PID antes de executar os estados
    Permite que os estados sobrescrevam o resultado do PID se necessário
2018-04-09 Continuação da evasão de obstáculos
2018-04-09 Corrige medida do suporte da coluna central
    [(TK) - Suporte Coluna Central.SLDPRT]
2018-04-10 Corrige altura do suporte da coluna central
    As peças foram reenviadas para a gestão.
    [(TK) - Suporte Bateria e ESC.SLDPRT, (TK) - Suporte Coluna Central.SLDPRT]
2018-04-10 Corrige a lógica de retorno do método SonicArray::update
    [SonicArray.cpp, SonicArray.h]
2018-04-10 Corrige erro de digitação no nome de uma varíavel
    Isso causava um erro de compilação
    [Mega.ino, States.cpp, Variables.cpp, Variables.h]
2018-04-11 Cria lógica para fazer a busca rotacionando o servo da câmera
2018-04-11 Faz com que os estados possam escolher o que é calculado após sua execução
2018-04-11 Corrige código dos estados em relação ao PID
    [States.cpp]
2018-04-11 Troca de estado ao receber dados da câmera
2018-04-11 Corrige variável usada para guardar distância do alvo até a câmera
    [CommandHandlers.cpp]
2018-06-18 Início da nova placa de alimentação
    A nova placa concerta os erros do transistor e suas conexões
    [Alimentação v2.PcbDoc, Alimentação v2.SchDoc]
2018-06-18 Arrumação do esquemático
    [Alimentação v2.SchDoc]
2018-06-19 Finalização da nova placa de alimentação
    [Alimentação v2.PcbDoc, Alimentação v2.SchDoc]
2018-06-20 Corrige pinagem para ficar de acordo com a placa
    [Mega.ino, Pins.h]
2018-06-20 Adiciona evento de parada enviado pelo raspberry pi
2018-06-20 Comenta o processamento do botão
    Por hora ele não funciona e interfere no funcionamento do resto do código
    [Mega.ino, States.cpp]
2018-06-20 Reporta ao raspberry (ou PC) que a posição do alvo foi recebida
    Apenas para fins de teste
2018-06-20 Corrige problemas nas threads de comunicação entre os dispositivos
    [ArduinoMessageHandlers.py, BluetoothMessageHandlers.py, BluetoothMessagingThread.py, MessagingThread.py]
2018-06-20 Tentativa de correção no processamento do botão
2018-06-20 Gira os KK's para fora
    [Alimentação v2.PcbDoc, Alimentação v2.SchDoc]
2018-06-20 Retira print do código de recepção de mensagens
2018-06-20 Melhora o nome de uma variável
2018-06-20 Mudanças na placa de alimentação
    [Alimentação v2.PcbDoc, Alimentação v2.SchDoc]
2018-06-20 Mudança no footprint transistor
2018-06-21 Conserto da placa de alimentaçao
    inicio da placa teste caso seja necessaria e a placa de alimentação v2
    [Alimentação v2.PcbDoc, Alimentação v2.SchDoc, Placa teste.PcbDoc, Placa teste.PrjPcb, Placa teste.SchDoc]
2018-06-21 Retira jumper
    [Alimentação v2.PcbDoc]
2018-06-21 Corrige calculo de direção do objeto detectado em relação a câmera
2018-06-21 Corrige problemas na classe de controle de comunicação
    -Ignora a primeira mensagem recebida pra evitar tentar processar uma mensagem que não foi recebida completamente;
    -Otimiza a remoção de characters inválidos
    [MessagingThread.py]
2018-06-21 Corrige erro onde uma mensagem mal recebida pode corromper a thread de comunicação
    [MessagingThread.py]
2018-06-21 Diminui um pouco a performance ro código de detecção
    A performance do raspberry pi é muito superior a do arduino, e assim o arduino não é capaz de acompanhar o rpi
2018-06-21 Corrige implementação da interpolação linear para float
2018-06-21 Ajustes na placa de alimentação
    [Alimentação v2.PcbDoc, Alimentação v2.SchDoc]
2018-06-21 Corrige comportamento de seguir alvo pela imagem
    [CommandHandlers.cpp, Constants.h, Mega.ino, States.cpp]
2018-06-21 Um monte de coisas
2018-06-23 Um monte de coisas²
    Leitura dos canais do receptor (2/3 concluido);
    Sensores de ultrassom marcam a distância (eles oscilam muito. Implementar um filtro)
2018-06-23 Ajustes nas placas v2 e teste
    [Alimentação v2.SchDoc, Placa teste.PcbDoc, Placa teste.SchDoc]
2018-06-23 Pequenas modificações na placa teste
    [Placa teste.PcbDoc, Placa teste.SchDoc]
2018-06-23 Corrige implementação na comunicação do rpi com o arduino
    [ArduinoCommands.py, ArduinoMessageHandlers.py, ArduinoMessagingThread.py, BluetoothMessageHandlers.py, CommandHandlers.cpp, CommandHandlers.h, CommonMessageHandlers.py, Constants.h]
2018-06-24 Calcula a distância até o objeto diretamente no raspberry pi
    Facilita fazer qualquer mudança e implementação de filtro, pois não será necessário carregar o código no arduino para ser testado
2018-06-24 Muda a forma como a execução do PID é controlada
    Modo manual e automático
2018-06-24 Implementa dois filtros para serem usados no raspberry pi
    A ideia é filtrar a direção e distância enviados para o arduino e assim reduzir as oscilações nele.
    Qual os filtros tiverem sido testados e soubermos o melhor filtro para cada caso e os parâmetros corretos eles devem passar a ser utilizados no próprio arduino
2018-06-24 Padroniza o número de espaços por tabulação para 4
2018-06-25 Corrige erro na leitura dos ultrassons
    [SonicArray.cpp]
2018-06-25 Padroniza a tabulação nos arquivos que ficaram faltando
2018-06-25 Corrige os handlers que lidam com a placa do MPU
    [CommandHandlers.cpp, CommandHandlers.h, Variables.cpp, Variables.h]
2018-06-26 Filtro de passa baixa simples
2018-06-28 Placa de alimentação v3
    [Alimentação v3.PcbDoc, Alimentação v3.SchDoc]
2018-06-29 Ajustes organizacionais que possibilitam a adição do conversor
    [Alimentação v3.PcbDoc]
2018-06-29 Corrige e testa os filtros implementados
    O filtro funcionou mas ainda requer algum trabalho
    [ArduinoCommands.py, CommandHandlers.cpp, Constants.h, Mega.ino, PIDHelper.cpp, States.cpp, VideoStream.py]
2018-08-12 Mudanças no código feitas durante a winter
    Corrige erros devido a versão do python no Debian não ser a mais atualizada, e inclui mensagens auxiliares
    [ArduinoCommands.py, ArduinoMessageHandlers.py, BluetoothMessageHandlers.py, CommandHandlers.cpp, CommandHandlers.h, Constants.h, Mega.ino, MessageCodes.py]
2018-09-29 Código para extrair automaticamente imagens de amostra para o trainamento de haar cascade
2018-10-23 Separa implementação da detecção dos objetos do código de rastreamento
2018-10-23 Melhora API das classes de rastreio
    A ideia é facilitar a implementação de outros algoritmos de rastreamento
2018-10-23 Implementa algoritmo de rastreio CorrelationTracker da dlib
2018-10-23 Corrige calculo de FPS para considerar melhoria na performance decorrente da atualização para o OpenCv 3.4.3
    O código rodava tão rápido que resultava em uma divisão por 0
2018-10-24 Adiciona script que simula detecção e rastreio em arquivos de vídeo
2018-10-24 Corrige implementação do framework de injeção de dependencias para funcionar com o python 3.7
2018-10-29 Programa de extração de amostras
2018-10-29 Corrige liberação de recursos ao finalizar threads de vídeo
    [FileVideoStream.py, PiVideoStream.py, VideoStream.py, WebcamVideoStream.py]
2018-10-29 Implementa tracker de multiplos objetos
    Ainda é necessário implementar um seletor de qual é o alvo atual
2018-10-29 Inicia seleção de alvo
    Por enquanto está pegando o alvo mais próximo
2018-10-29 Ignora modelos do rastreador GOTURN
    São arquivos muito pesados que não faz muito sentido estarem no repositório.
    Caso deseje tê-los, baixem dê: https://www.dropbox.com/sh/77frbrkmf9ojfm6/AACgY7-wSfj-LIyYcOgUSZ0Ua?dl=0
    E extraia os arquivos no diretório do arquivo main.py (ou do programa que irá fazer uso desse modelo)
2018-10-29 Adiciona alguns comentários aos algoritmos de rastreamento do OpenCV
2018-10-29 Corrige implementação dos filtros de passa baixa e média móvel
2018-10-30 Corrige calculo de distância
    [VideoStream.py]
2018-10-30 Update firmware/pi/videoStream/VideoStream.py
    Remove print perdido
2018-11-04 Modifica extrator de amostras para evitar muitas imagens "repetidas"
2018-11-11 Corrige checagem de tempo para a mensagem de temperatura
